Kamilr616/SmartBotAPI/docs/architecture.md

# Architecture & Communication

This document describes how the SmartBotAPI system is put together: the three main components, the real-time communication protocol between them, and the path a measurement takes from sensor to screen.

## Components

| Component | Location | Role |
|---|---|---|
| **Robot firmware** | `src/arduino/sketch_robot_signalr/` | Samples sensors, drives motors, maintains a WebSocket connection to the hub |
| **Web server** | `src/server/SmartBotBlazorApp/` | Hosts the SignalR hub, processes depth frames into images, persists telemetry, serves the dashboard |
| **Dashboard client** | `src/server/SmartBotBlazorApp.Client/` + server-rendered pages | Control UI (Blazor WebAssembly) and live/historical visualization pages (Blazor Server) |

```mermaid
sequenceDiagram
    participant R as Robot (ESP32-C3)
    participant H as SignalHub (/signalhub)
    participant S as Services (ImageProcessor, MeasurementService)
    participant D as Dashboard (browser)

    R->>H: ReceiveRobotData(user, measurements[7], rawMatrix[64], avgDistance)
    H->>S: round, save to DB (throttled ≤ 1/s)
    H->>S: render heatmap PNG + interpolate 8×8 → 32×32
    H-->>D: ReceiveBase64Frame(user, measurements, heatmapBase64, avgDistance)
    H-->>D: ReceiveMatrix(user, measurements, interpolated[1024], avgDistance)

    D->>H: SendMovementCommand(user, motorA, motorB)
    H-->>R: ReceiveRobotCommand(motorB, motorA)
    R->>R: set PWM, reset idle timer
```

## Transport

- **Protocol:** SignalR JSON hub protocol over WebSocket. The browser uses the official SignalR client; the ESP32 speaks the protocol directly — it performs the JSON handshake (`{"protocol":"json","version":1}`), then exchanges invocation messages (type `1`), each terminated by the SignalR record separator `0x1E`.
- **Security:** dashboards authenticate with the ASP.NET Core Identity cookie. Interactive Server pages exchange their authenticated session for a five-minute, data-protected operator token; the WebAssembly diagnostics page uses the cookie directly. The robot supplies `SECRET_API_KEY` as the SignalR `access_token` query value, which is compared in constant time with `RobotApiKey` (minimum 32 characters). Hub methods enforce operator-versus-robot roles, and production transport uses TLS (`wss://`).
- **Hub endpoint:** `/signalhub` (mapped in `Program.cs`).
- **Reconnection:** the firmware retries the WebSocket every 5 s (`WS_RECONNECT_INTERVAL`); response compression is enabled server-side for `application/octet-stream`.

A capture of real handshake and invocation messages is available in `other/signalr_json.txt`.

## Motion Control

`JoystickInputHandler` treats the on-screen joystick as a two-dimensional,
proportional differential-drive controller. After converting browser coordinates so
positive `y` means forward motion, it applies two dead zones and mixes throttle with
steering:

```text
if |x| < 0.15 and |y| < 0.15:
    left = right = 0
else if |x| < 0.35:
    left = right = y
else:
    left  = y + x
    right = y - x

motor PWM = clamp(motor, -1, 1) × 255
```

The mix is continuous rather than limited to the dominant direction displayed by the
UI label. Equal motor values produce straight motion, unequal values produce a curve,
and opposite values at `y = 0` rotate the robot around its own axis. The output range
is `-255…+255`, where the sign selects motor direction and the magnitude selects PWM
duty.

`keyboardInputHandler` provides a discrete fallback using the same motor-command
contract:

| Input | Left motor | Right motor | Motion |
|---|---:|---:|---|
| `ArrowUp` | 255 | 255 | Forward |
| `ArrowDown` | -255 | -255 | Reverse |
| `ArrowLeft` | 255 | -255 | Rotate left in place |
| `ArrowRight` | -255 | 255 | Rotate right in place |
| Pointer/key release | 0 | 0 | Stop |

The dashboard samples the held joystick continuously but throttles outgoing SignalR
commands to one every 250 ms. Pointer/key release sends `(0, 0)` immediately. The
firmware independently clamps received values and stops both motors after 700 ms
without a command, so loss of browser or network control fails safe.

## Hub Contract (`Hubs/SignalHub.cs`)

### Client → Server (invocable methods)

| Method | Parameters | Behavior |
|---|---|---|
| `SendMovementCommand` | `user: string`, `motorA: int`, `motorB: int` | Broadcasts `ReceiveRobotCommand(motorB, motorA)` to all *other* clients (i.e., the robot) |
| `ReceiveRobotData` | `user: string`, `measurements: double[7]`, `rawMatrix: ushort[64]`, `avgDistance: ushort` | Persists the measurement, generates visualizations, broadcasts to dashboards |
| `SendMessage` | `user: string`, `message: string` | Echo/broadcast utility (`ReceiveMessage` to all clients) |
| `ReceiveMessage` | `user: string`, `message: string` | Replies `"Message received!"` to the caller |

### Server → Client (events)

| Event | Consumers | Payload |
|---|---|---|
| `ReceiveRobotCommand` | Robot | `motorB: int`, `motorA: int` — PWM values in `-255…+255` |
| `ReceiveBase64Frame` | `/image-receiver-server`, `/chat` | `user`, rounded `measurements`, base64 PNG heatmap, `avgDistance` |
| `ReceiveMatrix` | `/matrix-receiver-server` | `user`, rounded `measurements`, interpolated `ushort[1024]` (32×32), `avgDistance` |
| `ReceiveMessage` | Any | `user`, `message` |

### Measurement array layout

The `measurements` array always has 7 elements, in this order:

| Index | Value | Unit |
|---|---|---|
| 0–2 | Acceleration X, Y, Z (surge, sway, heave) | m/s² |
| 3–5 | Rotation X, Y, Z (roll, pitch, yaw) | °/s |
| 6 | Temperature | °C |

`rawMatrix` is the row-major 8×8 VL53L5CX depth frame in millimeters; `avgDistance` is the average distance of the frame's central 4×4 zone, in millimeters.

## Server-Side Processing

Both transformations live in `ImageProcessor.cs` and run per incoming frame:

1. **Heatmap generation** — the 8×8 depth frame is normalized to the 10–3500 mm range and mapped onto a red → yellow → green → blue → purple gradient, rendered with ImageSharp and returned as a base64-encoded PNG (displayed at 512×512 in the browser).
2. **Bilinear interpolation** — the same frame is upsampled to 32×32 (`ushort[1024]`) for the interactive matrix view, where each cell is colored client-side.

`MeasurementService.cs` rounds measurements to 2 decimal places for display and uses one static timestamp to throttle database writes to approximately one insert per second for the whole server process. The throttle is shared by all robots and service instances; it is not maintained per stream. The timestamp check is not protected by a concurrency lock, so it is a load-reduction mechanism rather than a strict rate-limit guarantee.

## Persistence

- **ORM:** Entity Framework Core (SQL Server provider). Migrations are applied automatically at startup (`Database.Migrate()` in `Program.cs`).
- **Entity:** `Measurement` (`Data/Measurement.cs`) — `Id`, `RobotId` (≤ 50 chars), `TemperatureC`, `AccelerationX/Y/Z`, `RotationX/Y/Z`, `AvgDistance`, `Timestamp`.
- **Connection resolution order:** `SmartBotDBConnectionString` environment variable → `ConnectionStrings:DefaultConnection` in `appsettings.json`.

## Rendering Model

The web application uses Blazor's hybrid rendering:

- **Interactive Server** pages (`SmartBotBlazorApp/Components/Pages/`) — live visualization and robot-control pages that hold a SignalR connection server-side.
- **Interactive WebAssembly** pages (`SmartBotBlazorApp.Client/Pages/`) — the `/chat` text-diagnostics page connects to the hub directly from WASM.

ASP.NET Core Identity provides the account system (registration, login, 2FA, management pages under `/Account/*`). Receiver and diagnostics pages require authorization. Registration and the no-email confirmation link are available in Development but disabled by default in other environments.
