Kamilr616/SmartBotAPI/docs/schemat.pdf

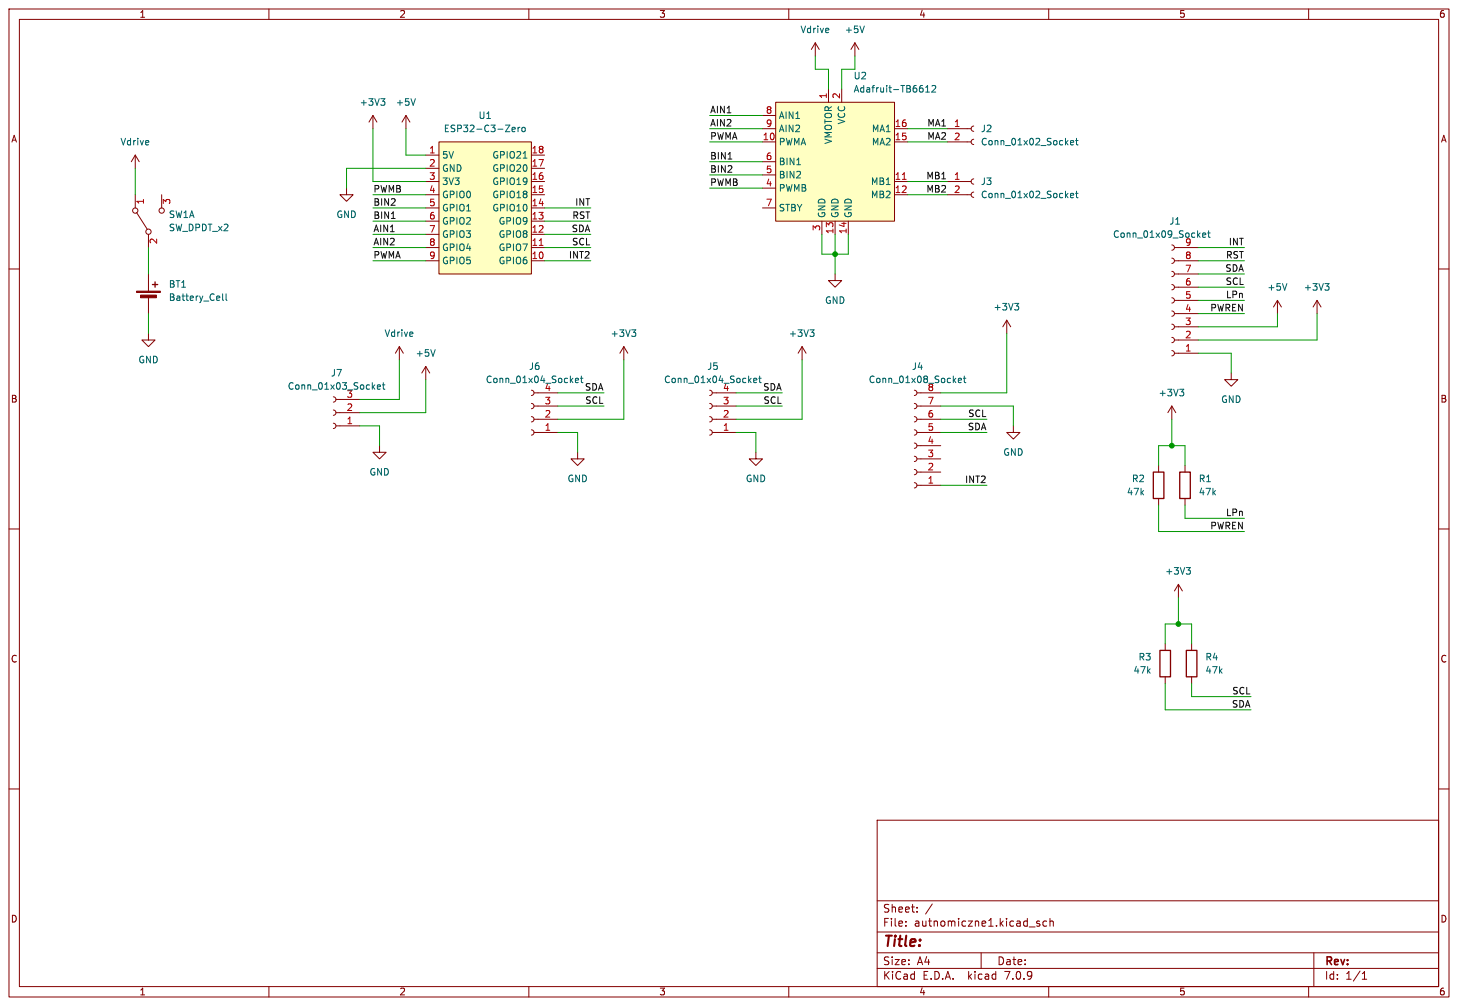
[picture p9: page 1]

1 PWMA 10 MB1 11 MB2 12 GND 13 GND 14 MA2 15 MA1 VCC 16

Id: 1/1 Title: File: autnomiczne1.kicad_sch Sheet: / GND
