Kamilr616/SmartBotAPI/src/arduino/sketch_robot_signalr/config.h

/**
 * @file config.h
 * @author Kamil Rataj
 *
 * Compile time configuration file.
 *
 * Copyright (c) 2024 Kamil Rataj
 * SPDX-License-Identifier: GPL-3.0-only
**/

#ifndef CONFIG_H
#define CONFIG_H


#define USE_SERIAL Serial
#define SERIAL_BAUDRATE 115200

#define SERVER_IP "your-server.example.com"
#define SERVER_PORT 443

#define MIN_DISTANCE 400 

#define MAX_IDLE_TIME 700

#define I2C_FREQ 400000 

#define WS_RECONNECT_INTERVAL 5000

#define TOF_RANGING_MODE SF_VL53L5CX_RANGING_MODE::CONTINUOUS
#define TOF_SHARPENER_PERCENT 18
#define TOF_TARGET_ORDER SF_VL53L5CX_TARGET_ORDER::CLOSEST
#define TOF_INTEGRATION_TIME 5
#define TOF_RANGING_FREQ 15

#define MPU_G_RANGE MPU6050_RANGE_2_G
#define MPU_DEG_RANGE MPU6050_RANGE_250_DEG
#define MPU_HZ_BAND MPU6050_BAND_21_HZ
#define MPU_HZ_CYCLE MPU6050_CYCLE_20_HZ

#define PIN_NEOPIXEL 10 

#define MOTOR_A_IN1 3
#define MOTOR_A_IN2 4
#define MOTOR_A_PWM 5
#define MOTOR_B_IN1 2
#define MOTOR_B_IN2 1
#define MOTOR_B_PWM 0

#define TOF_PIN 9


#endif  // CONFIG_H
