Kamilr616/SmartBotAPI/other/241111-183051-esp32-c3-devkitm-1/include/config.h

/* CONFIG_H */
#ifndef CONFIG_H
#define CONFIG_H

#define USE_SERIAL Serial
#define SERIAL_BAUDRATE 115200

#define SERVER_IP "smartbotapi.azurewebsites.net"
#define SERVER_PORT 443

#define PIN_NEOPIXEL_LED 10  // GPIO10

#define I2C_FREQ 1000000  // 1MHz

#define WS_RECONNECT_INTERVAL 5000

#define TOF_RANGING_MODE SF_VL53L5CX_RANGING_MODE::CONTINUOUS
#define TOF_SHARPENER_PERCENT 15
#define TOF_TARGET_ORDER SF_VL53L5CX_TARGET_ORDER::CLOSEST
#define TOF_INTEGRATION_TIME 5
#define TOF_RANGING_FREQ 10

//#define RGB_BRIGHTNESS 10 // Change white brightness (max 255)

#endif /* !CONFIG_H S*/
