Kamilr616/SmartBotAPI/other/arduino_alpha/arduino_alpha.ino

/*
  Read an 8x8 array of distances from the VL53L5CX
  By: Nathan Seidle
  SparkFun Electronics
  Date: October 26, 2021
  License: MIT. See license file for more information but you can
  basically do whatever you want with this code.

  This example shows how to read all 64 distance readings at once.

  Feel like supporting our work? Buy a board from SparkFun!
  https://www.sparkfun.com/products/18642

*/

#include "WiFi.h"
#include "AsyncUDP.h"
#include <Wire.h>
#include <SparkFun_VL53L5CX_Library.h> //http://librarymanager/All#SparkFun_VL53L5CX

const char * ssid = "*****";
const char * password = "*****";

AsyncUDP udp;

SparkFun_VL53L5CX myImager;
VL53L5CX_ResultsData measurementData; // Result data class structure, 1356 byes of RAM

int imageResolution = 0; //Used to pretty print output
int imageWidth = 0; //Used to pretty print output

void setup()
{
  Serial.begin(115200);
  delay(1000);
  Serial.println("SparkFun VL53L5CX Imager Example");

  Wire.begin(8,7); //This resets to 100kHz I2C
  Wire.setClock(400000); //Sensor has max I2C freq of 400kHz 
  
  pinMode(9,OUTPUT);
  digitalWrite(9,LOW);

  Serial.println("Initializing sensor board. This can take up to 10s. Please wait.");
  if (myImager.begin() == false)
  {
    Serial.println(F("Sensor not found - check your wiring. Freezing"));
    while (1) ;
  }
  
  myImager.setResolution(8*8); //Enable all 64 pads
  
  imageResolution = myImager.getResolution(); //Query sensor for current resolution - either 4x4 or 8x8
  imageWidth = sqrt(imageResolution); //Calculate printing width

  myImager.setRangingFrequency(15);
  myImager.startRanging();

    WiFi.mode(WIFI_AP);
    WiFi.softAP(ssid, password);
    if(udp.listen(1234)) {
        Serial.print("UDP Listening on IP: ");
        Serial.println(WiFi.localIP());
        udp.onPacket([](AsyncUDPPacket packet) {
            Serial.print("UDP Packet Type: ");
            Serial.print(packet.isBroadcast()?"Broadcast":packet.isMulticast()?"Multicast":"Unicast");
            Serial.print(", From: ");
            Serial.print(packet.remoteIP());
            Serial.print(":");
            Serial.print(packet.remotePort());
            Serial.print(", To: ");
            Serial.print(packet.localIP());
            Serial.print(":");
            Serial.print(packet.localPort());
            Serial.print(", Length: ");
            Serial.print(packet.length());
            Serial.print(", Data: ");
            Serial.write(packet.data(), packet.length());
            Serial.println();
            //reply to the client
            packet.printf("Got %u bytes of data", packet.length());
        });
    }
}

void loop()
{
  //Poll sensor for new data
  if (myImager.isDataReady() == true)
  {
    if (myImager.getRangingData(&measurementData)) //Read distance data into array
    {
      uint8_t data[128];
      int z = 0;
      //The ST library returns the data transposed from zone mapping shown in datasheet
      //Pretty-print data with increasing y, decreasing x to reflect reality
      for (int y = 0 ; y <= imageWidth * (imageWidth - 1) ; y += imageWidth)
      {
        for (int x = imageWidth - 1 ; x >= 0 ; x--)
        {
          data[z] = measurementData.distance_mm[x + y] >> 8;
          data[z+1] = measurementData.distance_mm[x + y] & 0xFF;
          Serial.print("\t");
          Serial.print(measurementData.distance_mm[x + y]);
          z+=2;
        }
        Serial.println();
      }
      udp.broadcast(data , 128);
      Serial.println();
    }
  }

  delay(5); //Small delay between polling
}
