Kamilr616/SmartBotAPI/src/arduino/sketch_robot_signalr/arduino_secrets.example.h

#ifndef ARDUINO_SECRETS_H
#define ARDUINO_SECRETS_H

// Copy to arduino_secrets.h. Use a URL-safe random value of at least 32 characters.
#define SECRET_API_KEY "replace-with-a-long-random-robot-api-key"

#define SECRET_SSID "your-wifi"
#define SECRET_PASS "your-password"
#define SECRET_SSID2 "fallback-wifi"
#define SECRET_PASS2 "fallback-password"
#define SECRET_SSID3 "third-wifi"
#define SECRET_PASS3 "third-password"

#endif
