Kamilr616/SmartBotAPI/(commit log)

2024-11-12 Platform.io arduino project
2024-11-12 arduino update
2024-12-06 time throttle
2024-12-09 Arduino code update
2024-12-10 Catch and print incoming arduino messages
2025-01-10 arduino fix
2025-01-12 motor directon fixed
2025-01-15 led color
2025-01-15 arduino release
2026-07-15 Pin implicit SDK pack versions
